Elias-m-S/deskdeck/hardware/fabrication/bom.csv

Qty | References | Value | Footprint | Note
1 | U1 | ESP32-S3 SuperMini | ESP32-S3_SuperMini_Socket | ESP32-S3FH4R2 module (4 MB flash, 2 MB PSRAM), plus 2x female header 1x9 2.54 mm
1 | J1 | OLED 1.3" SH1106 | OLED_1.3in_I2C_Socket | 128x64 I2C module, pin order GND VCC SCL SDA. Soldered in directly with a 1x4 pin header (2.5 mm spacer), no socket, so it sits flush in the enclosure
2 | SW1 SW2 | EC11 | RotaryEncoder_Alps_EC11E-Switch_Vertical_H20mm | EC11 rotary encoder with push button, 20 mm shaft
6 | SW3 SW4 SW5 SW6 SW7 SW8 | MX switch | SW_Cherry_MX_1.00u_PCB | Cherry MX compatible (Kailh/Outemu/Gateron), 3- or 5-pin
1 | U2 | PC817 UP | DIP-4_W7.62mm | PC817C optocoupler DIP-4
1 | U3 | PC817 DOWN | DIP-4_W7.62mm | PC817C optocoupler DIP-4
2 | R1 R2 | 470 | R_Axial_DIN0207_L6.3mm_D2.5mm_P7.62mm_Horizontal | 1/4 W carbon or metal film
2 | R3 R4 | 10k | R_Axial_DIN0207_L6.3mm_D2.5mm_P7.62mm_Horizontal | 1/4 W carbon or metal film
1 | J2 | VL53L1X sensor | PinHeader_1x04_P2.54mm_Vertical | Pin header 1x4 2.54 mm + 4-wire cable to the TOF400C module
1 | J3 | Desk | TerminalBlock_Phoenix_MKDS-1,5-3-5.08_1x03_P5.08mm_Horizontal | Screw terminal 3-pole, 5.08 mm pitch (Phoenix MKDS 1,5/3 or similar)
5 | H1 H2 H3 H4 H5 | M3 | MountingHole_3.2mm_M3 | M3 screws + stand-offs (enclosure)
