Elias-m-S/deskdeck/enclosure/keycaps/folder.3mf

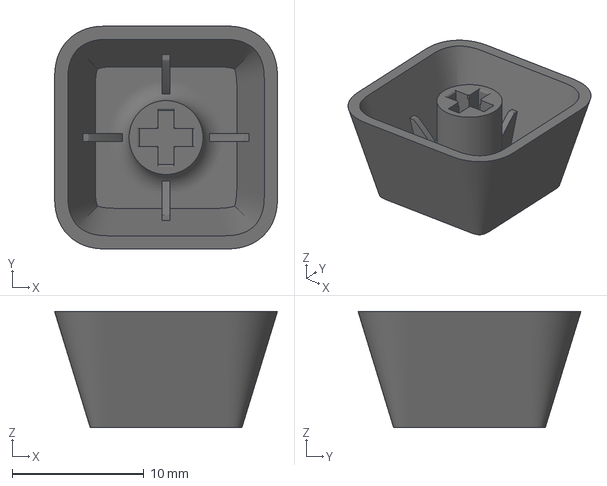
[picture p13: CAD file, 2026-11-11]
enclosure/keycaps/folder.3mf
16.9 x 16.9 x 8.80 mm
