Elias-m-S/deskdeck/enclosure/stl/OLED_Retainer.stl

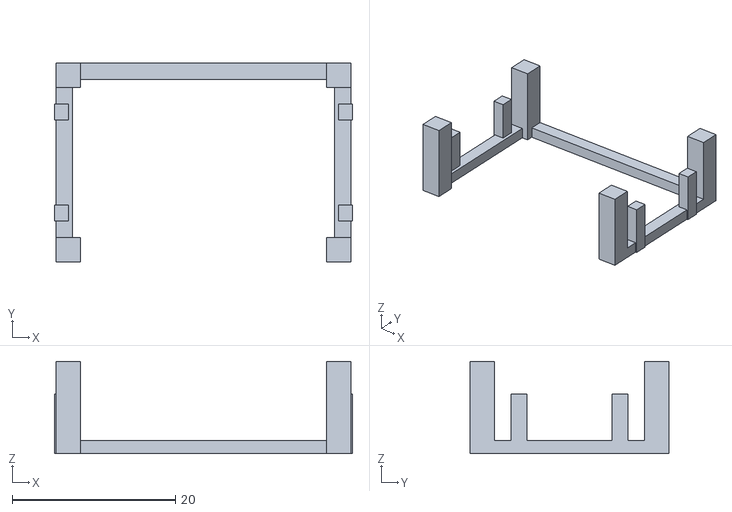
[picture p14: CAD file, 2026-11-11]
enclosure/stl/OLED_Retainer.stl
36.5 x 24.4 x 11.3
