Elias-m-S/deskdeck/enclosure/keycaps/sit_stand.3mf

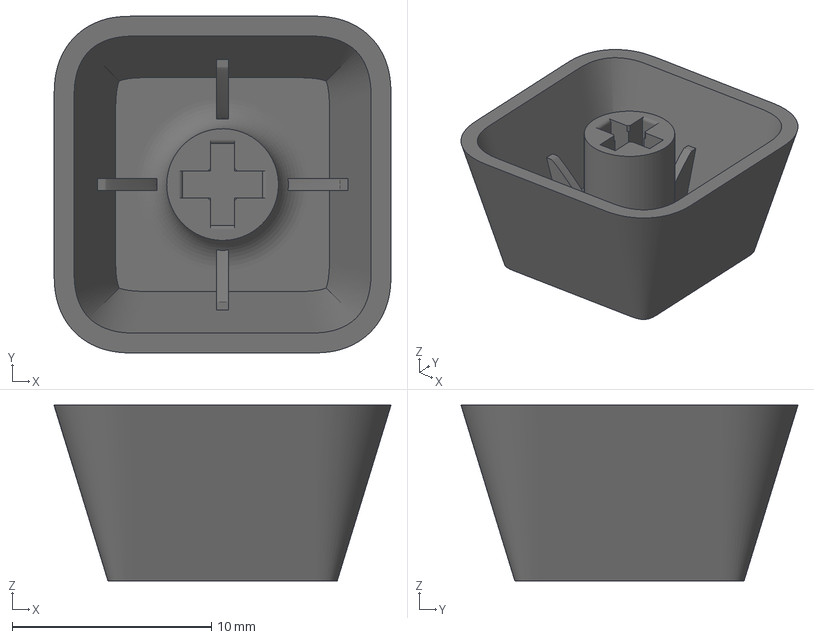
[picture p15: CAD file, 2026-11-11]
enclosure/keycaps/sit_stand.3mf
16.9 x 16.9 x 8.80 mm
