Elias-m-S/deskdeck/enclosure/stl/Bracket_right.stl

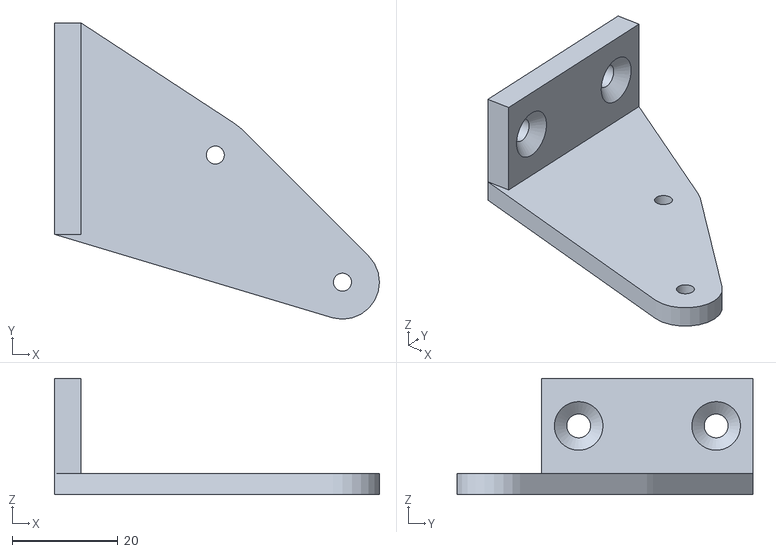
[picture p16: CAD file, 2026-11-11]
enclosure/stl/Bracket_right.stl
61.5 x 56.0 x 22.0
