Elias-m-S/deskdeck/enclosure/stl/enclosure.FCStd

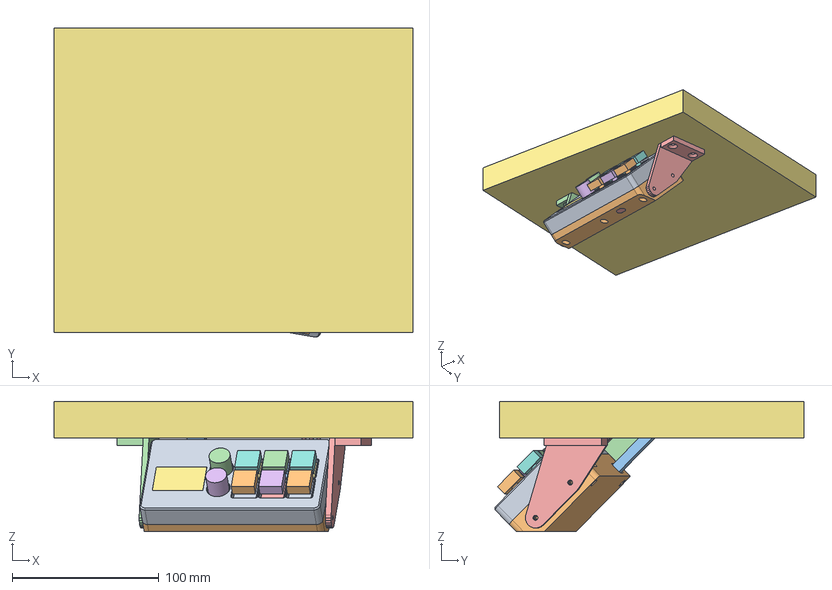
[picture p17: CAD file, 2026-11-11]
enclosure/stl/enclosure.FCStd
245.0 x 211.0 x 88.9 mm
Lid
Tray
OLED_Retainer
Bracket_left
Bracket_right
D_Board
D_MX0
D_Keycap0
D_MX1
D_Keycap1
D_MX2
D_Keycap2
D_MX3
D_Keycap3
D_MX4
D_Keycap4
D_MX5
D_Keycap5
D_EC11_0
D_Knob0
D_EC11_1
D_Knob1
D_OLED
D_OLED_parts
D_SuperMini
D_SuperMini_Pins
D_USB_plug
D_Terminal
D_Desk_cable
D_Sensor_header
D_U2
D_U3
D_R1
D_R2
D_R3
D_R4
D_Sensor
D_Sensor_cable
Desktop
