Elias-m-S/deskdeck/enclosure/stl/Tray.stl

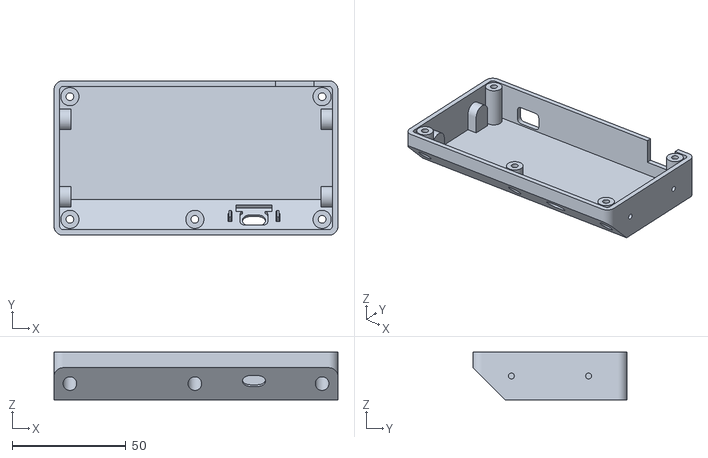
[picture p18: CAD file, 2026-11-11]
enclosure/stl/Tray.stl
125.0 x 68.0 x 21.0
