Elias-m-S/deskdeck/enclosure/stl/Lid.stl

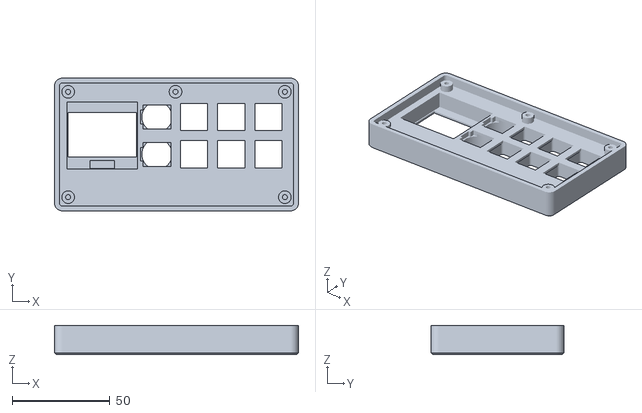
[picture p19: CAD file, 2026-11-11]
enclosure/stl/Lid.stl
125.0 x 68.0 x 15.1
