Elias-m-S/deskdeck/(list of files, cad)

Other CAD files:
enclosure/keycaps/down.3mf
enclosure/keycaps/terminal.3mf
enclosure/keycaps/up.3mf
enclosure/keycaps/bulb.3mf
enclosure/stl/Bracket_left.stl
