Elias-m-S/deskdeck/hardware/fabrication/deskdeck-schematic.pdf

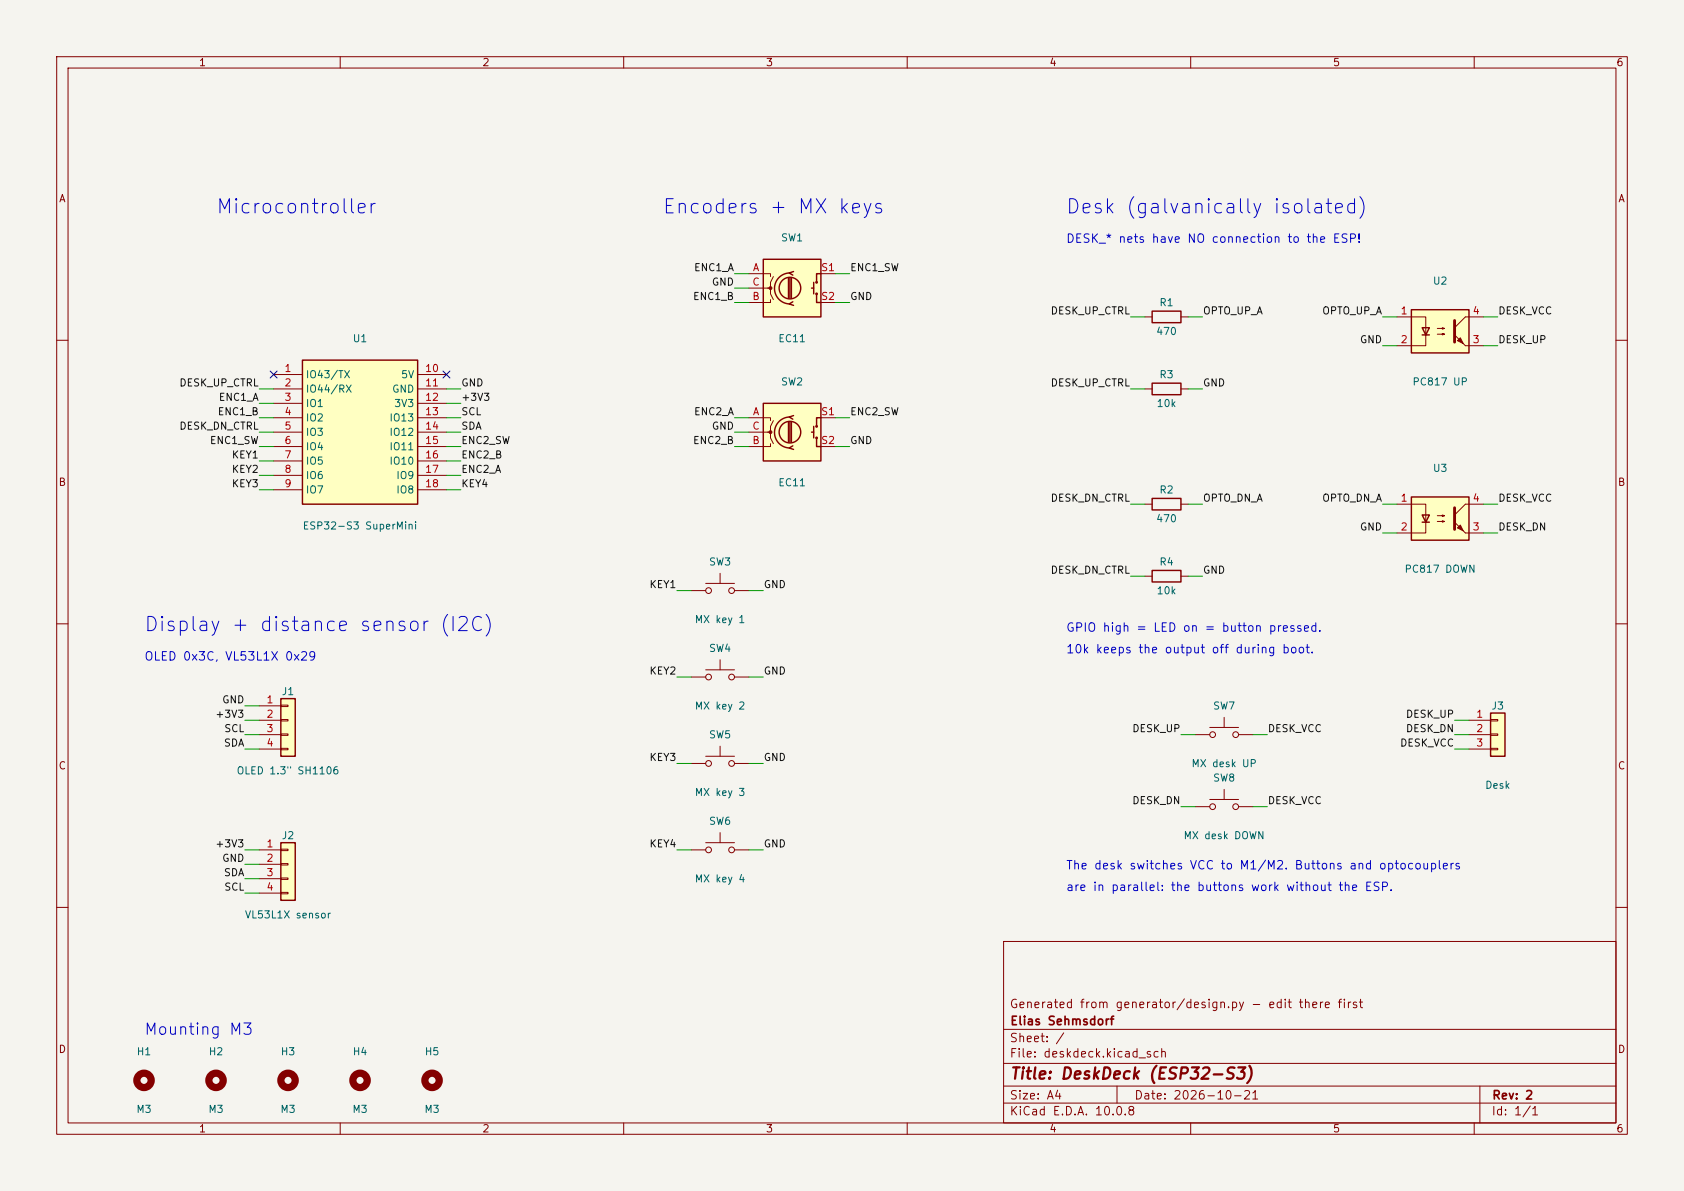
[picture p20: page 1]

DESK_* nets have NO connection to the ESP!

DESK_UP_CTRL SCL SDA GND +3V3 GND

GND are in parallel: the buttons work without the ESP.

GPIO high = LED on = button pressed.
10k keeps the output off during boot.

The desk switches VCC to M1/M2. Buttons and optocouplers

Generated from generator/design.py - edit there first H2M3

Size: A4 | Rev: 2
KiCad E.D.A. 10.0.8 | Id: 1/1
