Elias-m-S/deskdeck/hardware/deskdeck.kicad_pcb

## KiCad design hardware/deskdeck.kicad_pcb (2026-11-11)

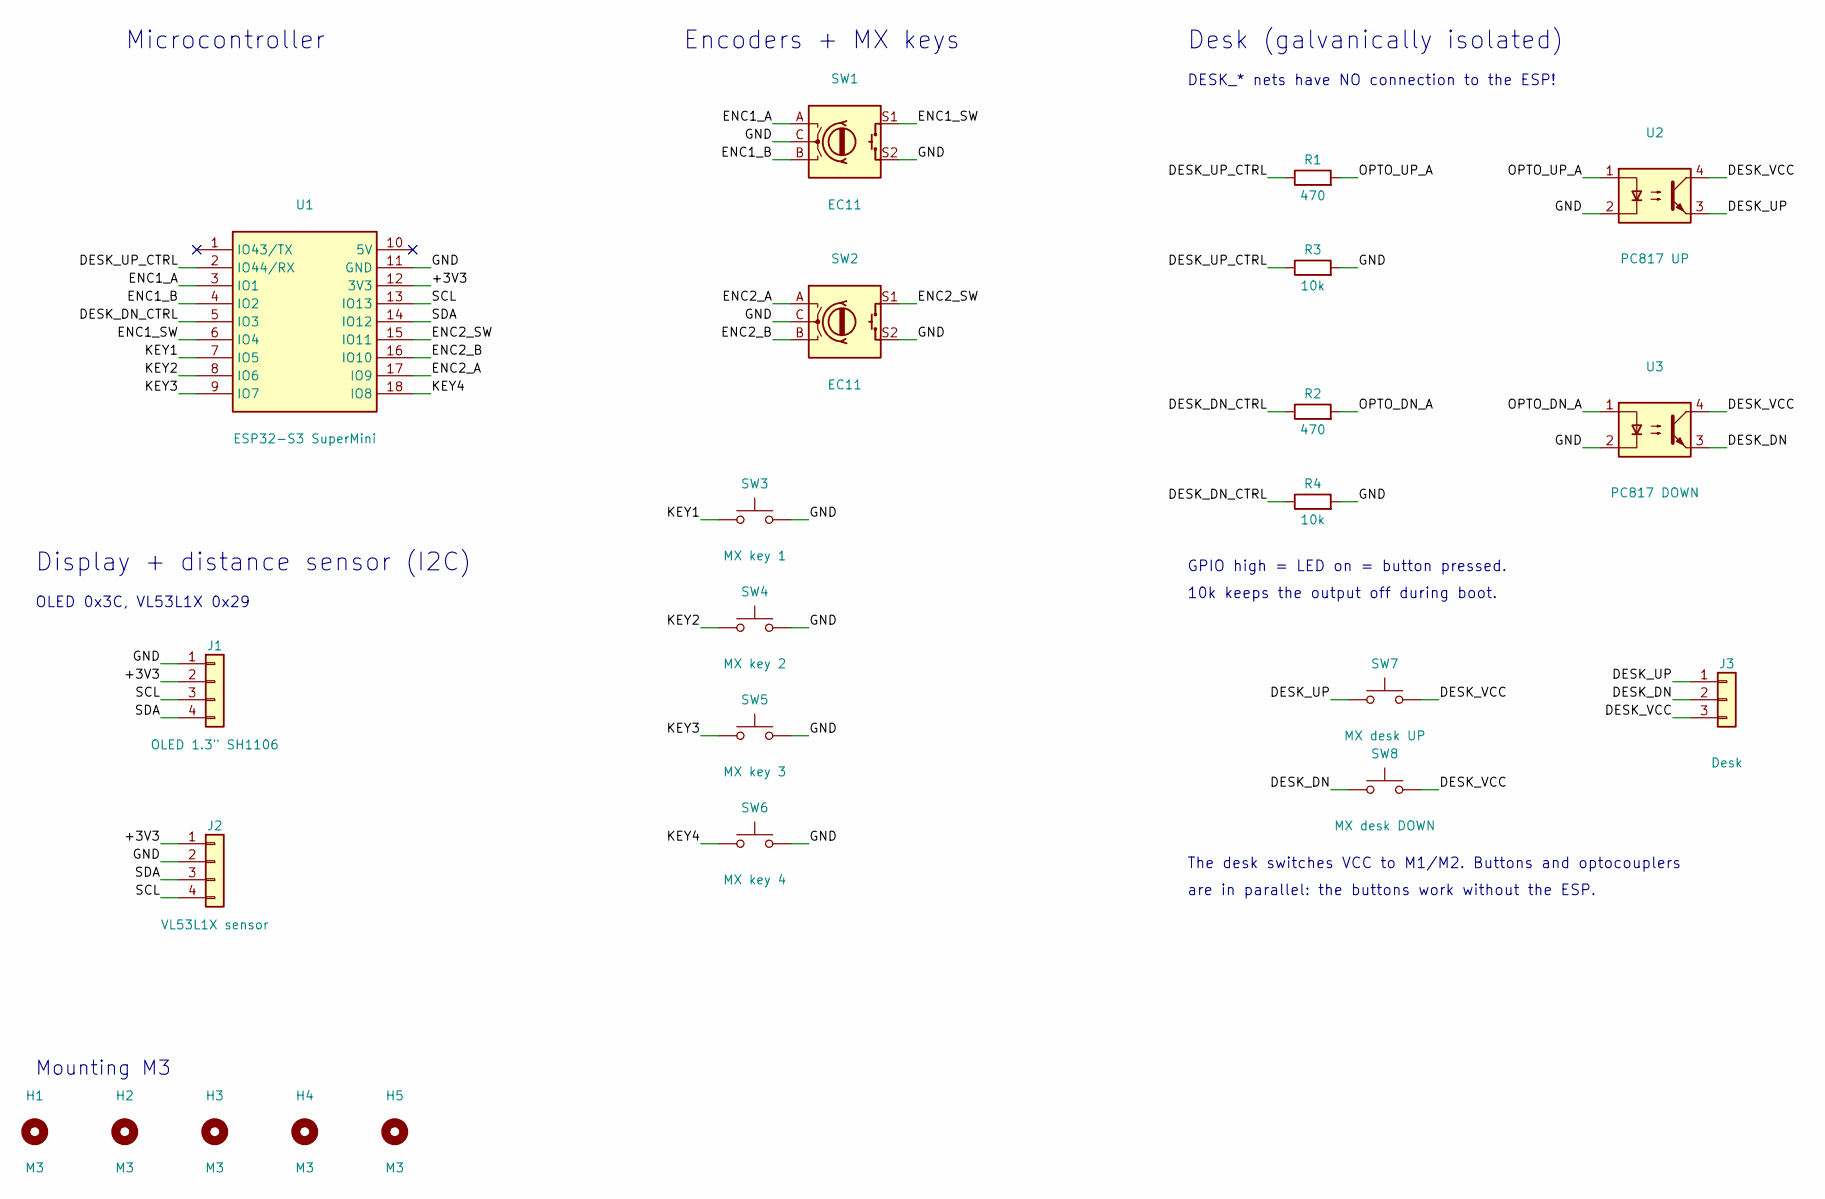
[picture p21: schematic deskdeck.kicad_sch, DeskDeck (ESP32-S3)]

Parts:
H1, H2, H3, H4, H5: M3; MountingHole_3.2mm_M3
J1: OLED 1.3" SH1106; OLED_1.3in_I2C_Socket
J2: VL53L1X sensor; PinHeader_1x04_P2.54mm_Vertical
J3: Desk; TerminalBlock_Phoenix_MKDS-1,5-3-5.08_1x03_P5.08mm_Horizont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
R1, R2: 470; R_Axial_DIN0207_L6.3mm_D2.5mm_P7.62mm_Horizontal
R3, R4: 10k; R_Axial_DIN0207_L6.3mm_D2.5mm_P7.62mm_Horizontal
SW1, SW2: EC11; RotaryEncoder_Alps_EC11E-Switch_Vertical_H20mm
SW3: MX key 1; SW_Cherry_MX_1.00u_PCB
SW4: MX key 2; SW_Cherry_MX_1.00u_PCB
SW5: MX key 3; SW_Cherry_MX_1.00u_PCB
SW6: MX key 4; SW_Cherry_MX_1.00u_PCB
SW7: MX desk UP; SW_Cherry_MX_1.00u_PCB
SW8: MX desk DOWN; SW_Cherry_MX_1.00u_PCB
U1: ESP32-S3 SuperMini; ESP32-S3_SuperMini_Socket
U2: PC817 UP; DIP-4_W7.62mm
U3: PC817 DOWN; DIP-4_W7.62mm

Connections:
+3V3: J1.2, J2.1, U1.12 (3V3)
DESK_DN: J3.2, SW8.1, U3.3
DESK_DN_CTRL: R2.1, R4.1, U1.5 (IO3)
DESK_UP: J3.1, SW7.1, U2.3
DESK_UP_CTRL: R1.1, R3.1, U1.2 (IO44/RX)
DESK_VCC: J3.3, SW7.2, SW8.2, U2.4, U3.4
ENC1_A: SW1.A, U1.3 (IO1)
ENC1_B: SW1.B, U1.4 (IO2)
ENC1_SW: SW1.S1, U1.6 (IO4)
ENC2_A: SW2.A, U1.17 (IO9)
ENC2_B: SW2.B, U1.16 (IO10)
ENC2_SW: SW2.S1, U1.15 (IO11)
GND: J1.1, J2.2, R3.2, R4.2, SW1.C, SW1.S2, SW2.C, SW2.S2, SW3.2, SW4.2, SW5.2, SW6.2, U1.11 (GND), U2.2, U3.2
KEY1: SW3.1, U1.7 (IO5)
KEY2: SW4.1, U1.8 (IO6)
KEY3: SW5.1, U1.9 (IO7)
KEY4: SW6.1, U1.18 (IO8)
OPTO_DN_A: R2.2, U3.1
OPTO_UP_A: R1.2, U2.1
SCL: J1.3, J2.4, U1.13 (IO13)
SDA: J1.4, J2.3, U1.14 (IO12)

Notes on the sheet:
Microcontroller
Display + distance sensor (I2C)
OLED 0x3C, VL53L1X 0x29
Encoders + MX keys
Desk (galvanically isolated)
DESK_* nets have NO connection to the ESP!
GPIO high = LED on = button pressed.
10k keeps the output off during boot.
The desk switches VCC to M1/M2. Buttons and optocouplers
are in parallel: the buttons work without the ESP.
Mounting M3

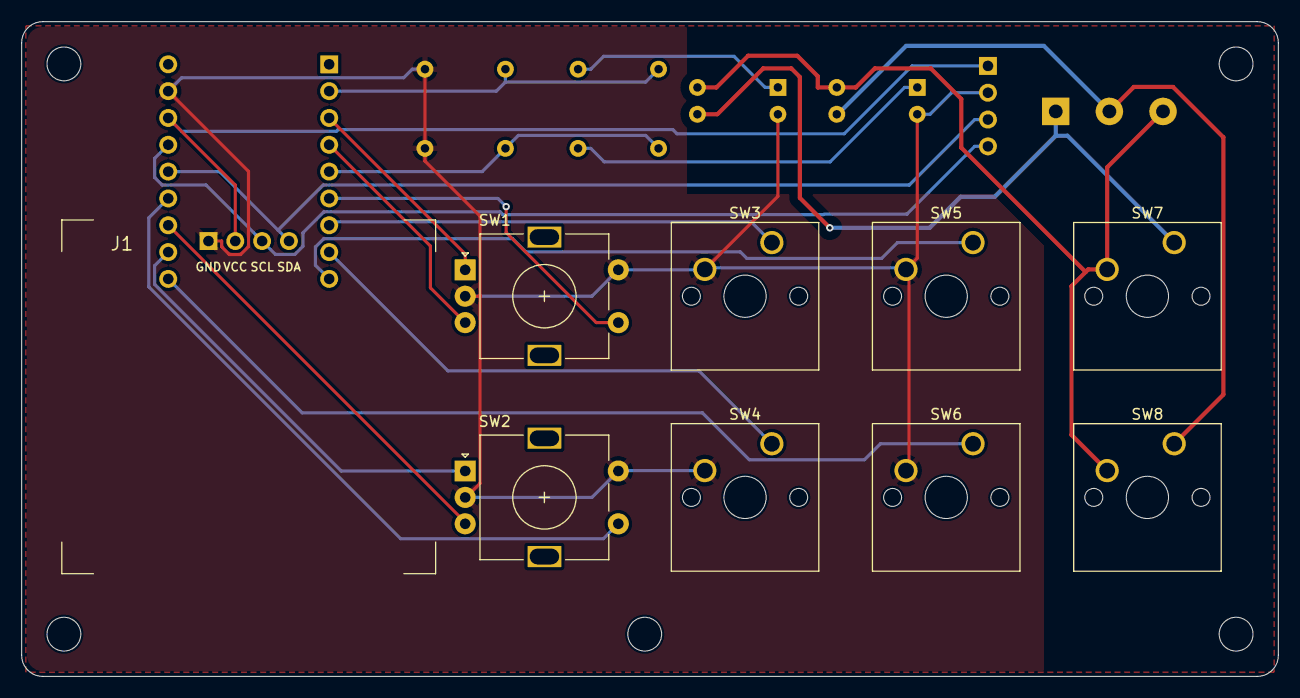
[picture p22: board deskdeck.kicad_pcb from above]

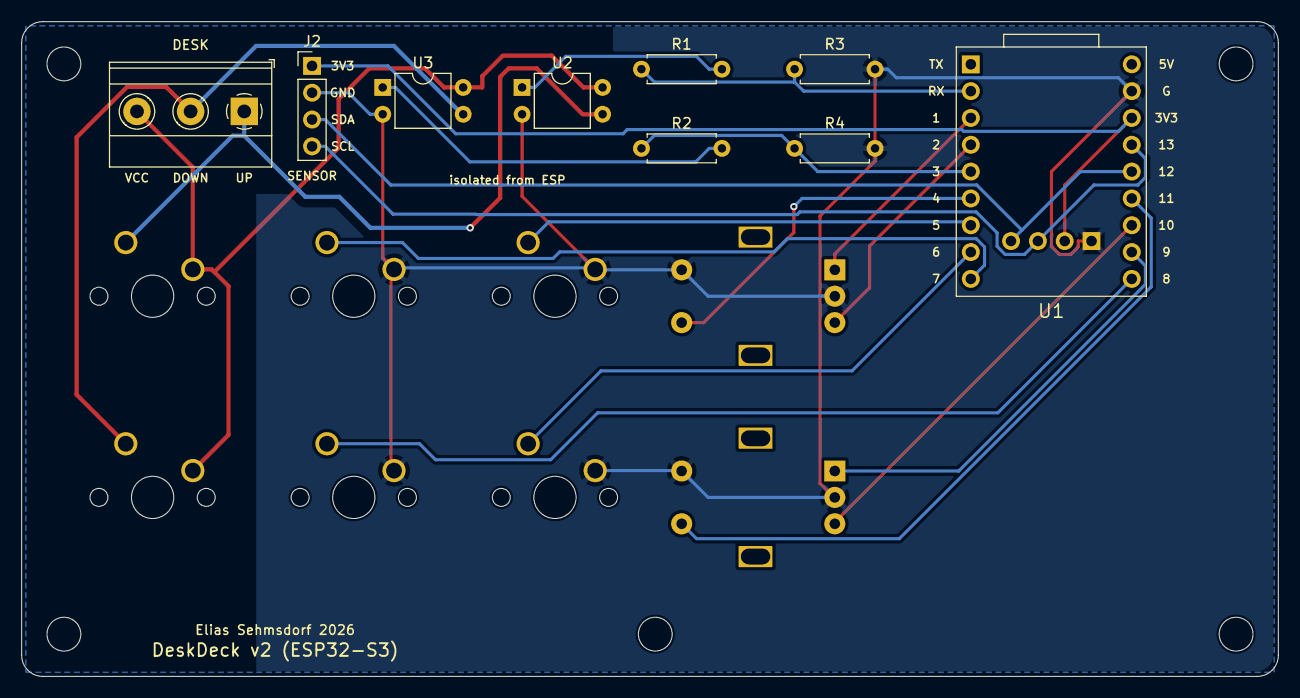
[picture p23: board deskdeck.kicad_pcb from below]

Board: 2 copper layers, 119.0 x 62.0 mm, 23 parts (9 on the bottom side), 21 nets.
