Elias-m-S/deskdeck/(commit log)

2026-11-11 Add ESP32-S3 firmware
    ESP-IDF project: input (PCNT encoders, debounced keys), UI state machine,
    SH1106 display driver, VL53L1X driver, desk drive logic with host-side
    simulation test, USB composite device (HID + CDC), MQTT link to Home
    Assistant, software reboot into the ROM bootloader.
    [actions.h, bootloader.c, bootloader.h, config.h, desk.c, desk.h, desk_logic.c, desk_logic.h]
2026-11-11 Add host daemon for per-app volume
    Python service bridging the device's CDC protocol to PipeWire/PulseAudio
    via pactl, with a systemd user unit and installer.
2026-11-11 Add KiCad hardware project (rev 2)
    Schematic, 2-layer board, project symbol/footprint libraries, Gerber ZIP
    for JLCPCB, BOM, schematic PDF, and the Python generator that builds
    schematic and board from design.py.
    [bom.csv, deskdeck.kicad_pcb, deskdeck.kicad_sch]
2026-11-11 Add parametric FreeCAD enclosure and keycaps
    Lid, tray, OLED retainer and desk brackets as print-ready STL, generated
    by enclosure.py from the board data in hardware/generator/design.py.
    Two-colour keycap 3MF files generated by keycaps.py.
    [Bracket_left.stl, Bracket_right.stl, Lid.stl, OLED_Retainer.stl, Tray.stl, bulb.3mf, down.3mf, enclosure.FCStd]
2026-11-11 host: also find boards still running the pre-rename firmware
2026-11-11 enclosure: preview mode for keycaps.py drawn from the committed 3MF meshes
    Regenerates docs/images/keycaps.png without the (unpublished) source
    caps, with English labels.
